xesscorp/Logic-Pod/README.md

Logic Pod
===================

Design files for a level-translator add-on board that allows a XuLA board to interface to 1.8V, 2.5V, 3.3V and 5.0V logic.
