xesscorp/Logic-Pod/(commit log)

2012-07-30 Initial checkin of Eagle files.
    [XuLA-LA.brd, XuLA-LA.sch]
2013-10-24 Added documentation to PCB layout.
    [XuLA-LA.brd, XuLA-LA.sch]
